cobrce/WaterLevel/Schematics/Schematic_bottom.png

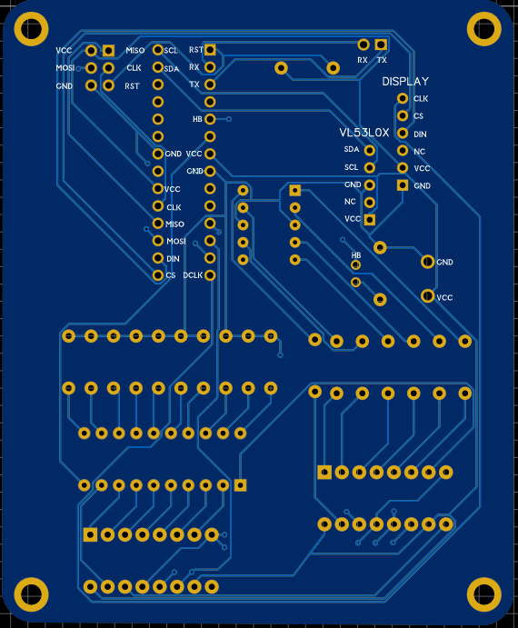
Schematics/Schematic_bottom.png
