cobrce/WaterLevel/Schematics/Schematic_top.png

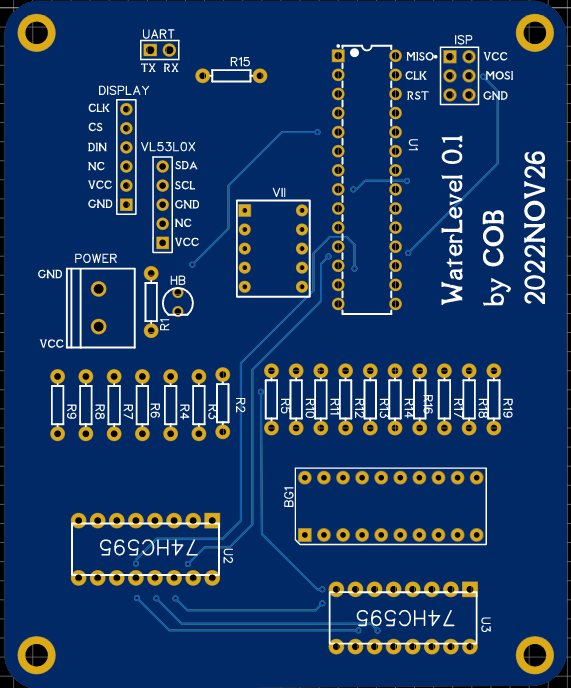
Schematics/Schematic_top.png
