cobrce/WaterLevel/Schematics/Schematic_WaterLevelAtmega328_2022-11-29.pdf

UART | ISP | Power

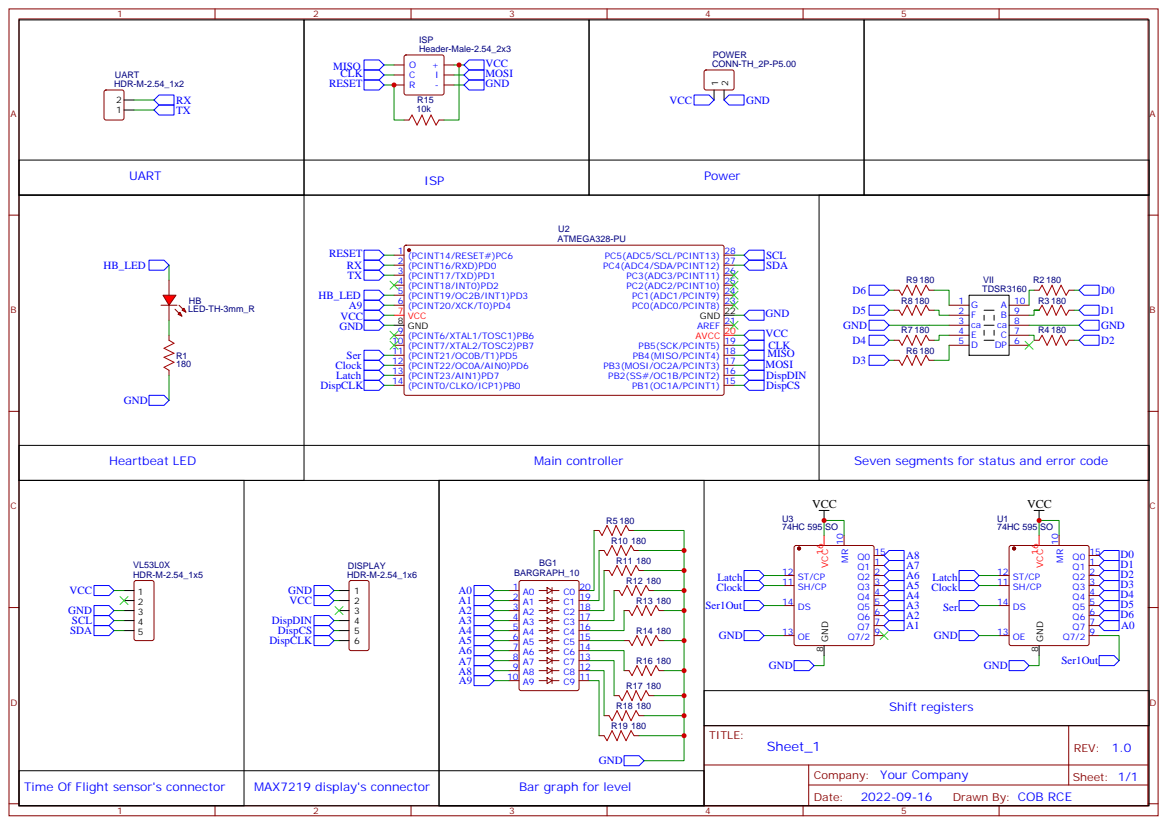
[picture p4: page 1]

Bar graph for level

Drawn By: COB RCE
