cobrce/WaterLevel/(list of files, drawings)

Other design files:
Schematics/EASYEDA_SCH_WaterLevelAtmega328_2022-11-29.json
simulation/simulation.pdsprj
