cobrce/WaterLevel/(commit log)

2021-11-27 Display calibration error code and internal values, updated DisplayInt to support percent and non percent values
    [main.c]
2021-11-27 Fixed "percent" wrong value by multiplying by 100
    [main.c]
2021-11-27 Measure distance limited to 700 overflow (sensor errors)
    [main.c]
2021-11-27 Display error code on measurement (added errors.h and main.eep to repo, should have been done earlier)
    [errors.h, main.c]
2021-11-30 MeasureDistance rewritten (had a problem measuring, too lazy to debug, rewritten a simpler version)
    [main.c]
2021-11-30 ClibrateFullHeight() enabled (and called) only when CALIBRATE is defined
2022-09-18 Added schematics
2022-11-23 Switched to Atmega328 with VL53L0X sensor
2022-11-24 Hearbeat pwm on led
2022-11-28 Moved calibration code to different file
2022-11-28 Added 7 segments and bargraph display for level and errors, code unfinished
    [main.c]
2022-11-29 Updated simulation
    [simulation.pdsprj]
2022-11-29 Updated sensor height default value
2022-11-29 Updated SevenSeg/Graphbar code (working) and fixed wrong SevenSeg values
    [main.c]
2022-11-29 Updated schematics
    [EASYEDA_SCH_WaterLevelAtmega328_2022-11-29.json]
2022-12-01 Moved seven segments code into a class, switched to cpp (program not tested yet)
2022-12-01 Fixed some comments (program is still not tested after switching to cpp)
    [sevenSegmentsFSM.h]
2022-12-01 The error code is poped out of the errors stack right after being read
    [main.cpp]
2022-12-01 Fixed pug where both level and error fsm display 'F' character at start
    [main.cpp]
2022-12-01 Set "value" in FSM as readable, fixed bug where FSM data are not updated, program tested on simlulation
    [main.cpp, sevenSegmentsFSM.h]
2022-12-02 Fixed some comments and moved others
    [main.cpp]
2022-12-02 Fixed some other comments
    [main.cpp]
2022-12-03 Fixed schematic in README.md
2023-03-11 Modified measureDistance, added low pass filter
2023-10-26 Changed constants (SENSOR_HEIGHT and alpha)
2023-10-26 Bugfix in measureDistance : 25cm max reading
    [main.cpp]
2024-06-09 Init messages : at startup flash 0000 after screen einit, 0001 after sensor init
2024-06-10 Calibration triggered by shorting rx an tx (not tested yet)
    [calibrate.h, main.cpp]
2024-06-14 Calibrate : calibrated value equals 98% of instead of 100%
